OlTsymbal/Kyrsova-robota/3-амплітуда виходу(увх 1кгц 250мв).jpeg

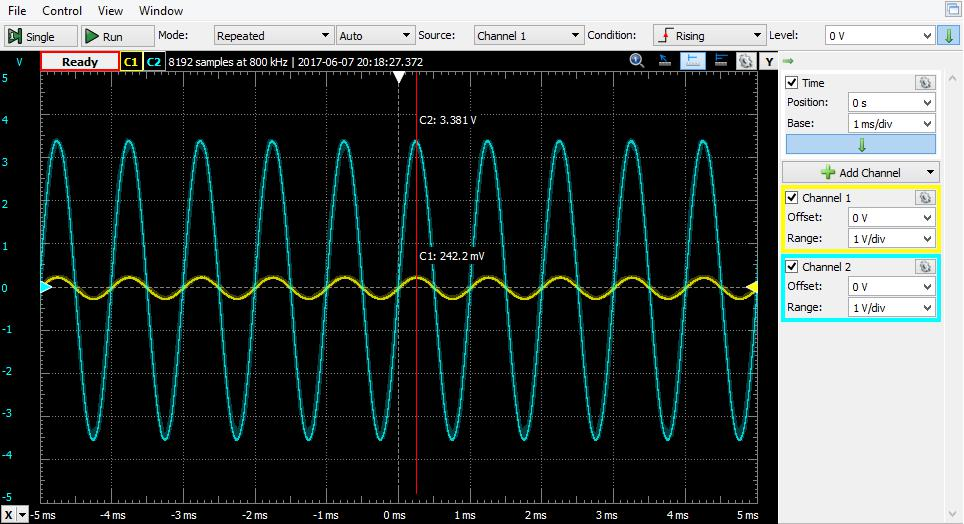
3-амплітуда виходу(увх 1кгц 250мв).jpeg
