OlTsymbal/Kyrsova-robota/3-амплітуда виходу1 - 50кгц.jpeg

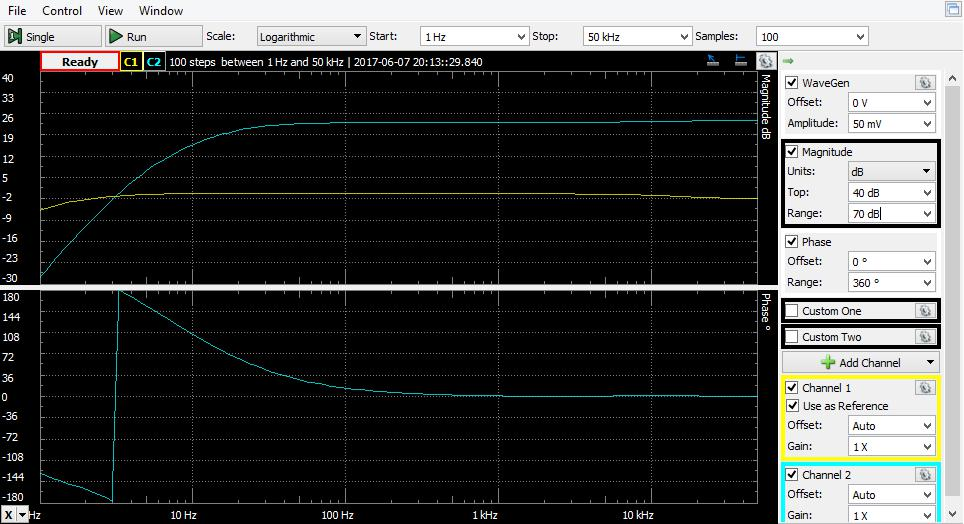
3-амплітуда виходу1 - 50кгц.jpeg
