OlTsymbal/Kyrsova-robota/3-амплітуда виходу2мгц.jpeg

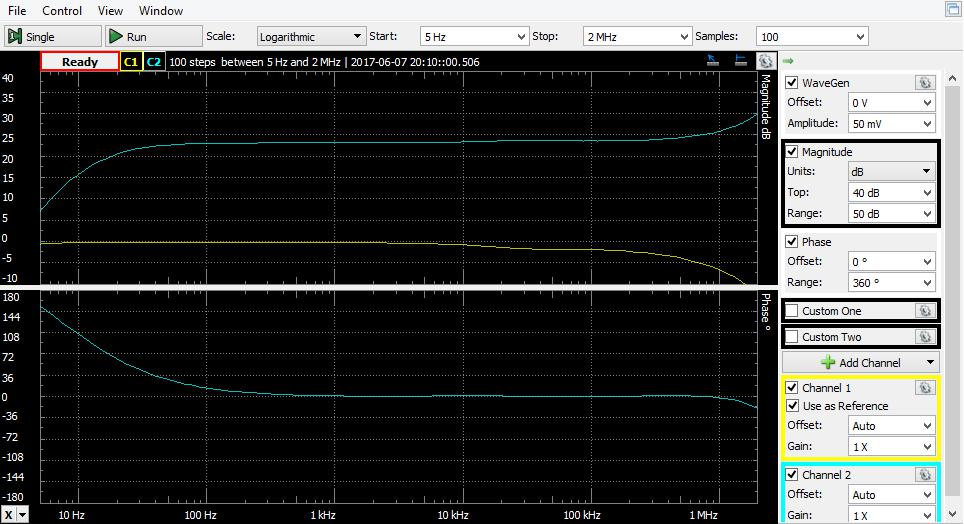
3-амплітуда виходу2мгц.jpeg
