OlTsymbal/Kyrsova-robota/3-амплітуда виходу(увх 0).jpeg

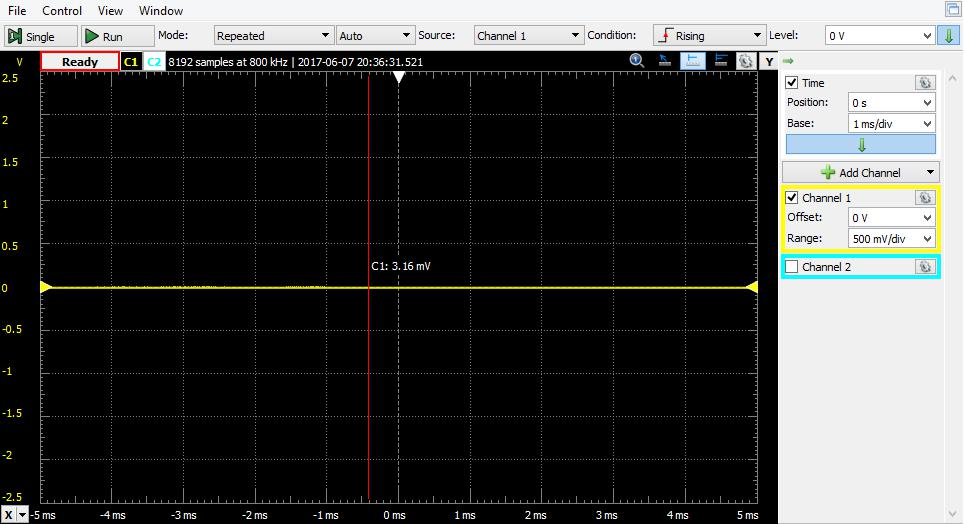
3-амплітуда виходу(увх 0).jpeg
