OlTsymbal/Kyrsova-robota/Виготовлення печатки.png

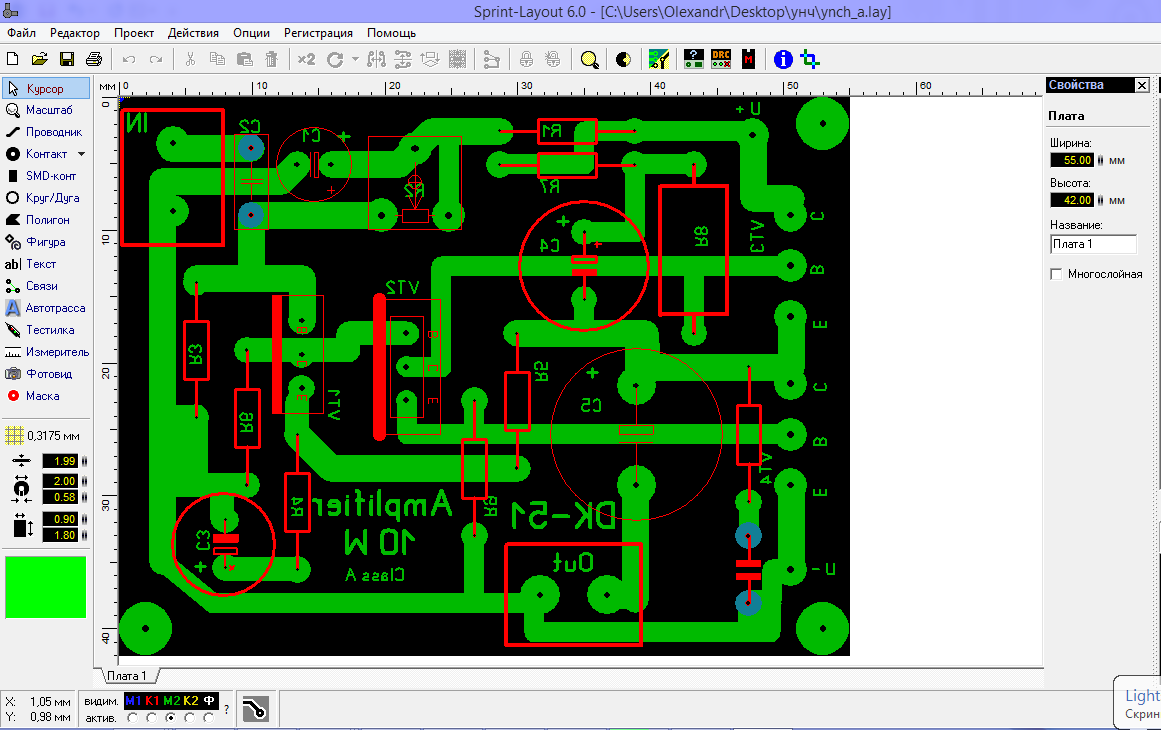
Виготовлення печатки.png
