OlTsymbal/Kyrsova-robota/Спрощена схема ВЕЛИКИЙ СИГНАЛ.png

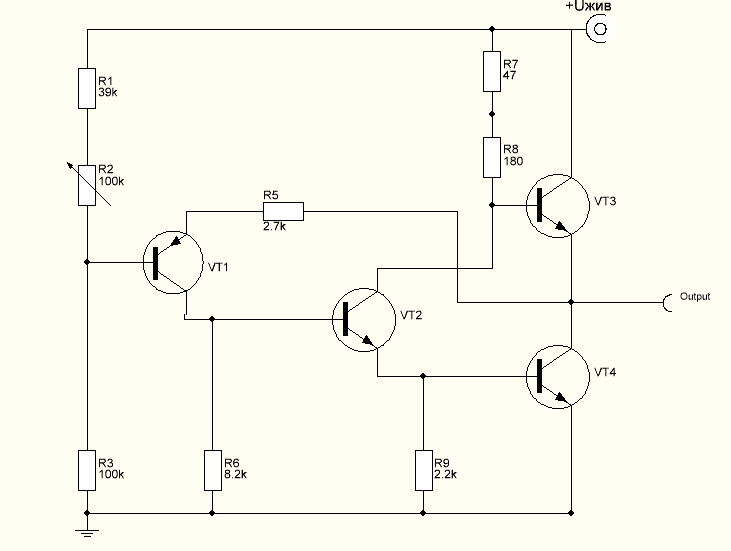
Спрощена схема ВЕЛИКИЙ СИГНАЛ.png
