OlTsymbal/Kyrsova-robota/ynch_a.lay].pdf

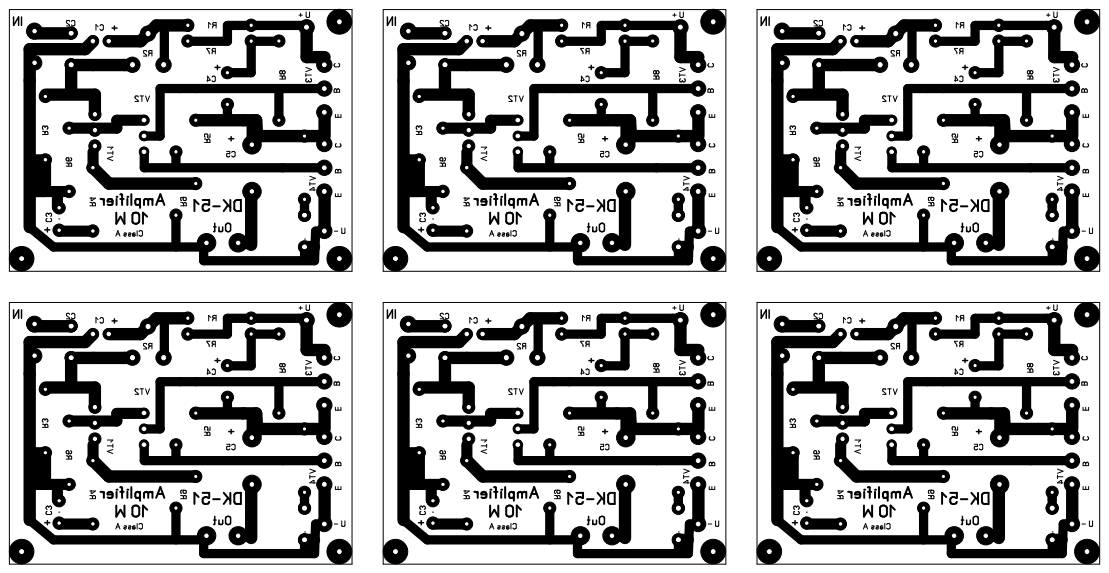
[picture p16: page 1]
