OlTsymbal/Kyrsova-robota/YN4.asc

C1: polcap; 100µ; V=25 Irms=250m Rser=0.6 Lser=0 mfg="Nichicon" pn="UPG1E101MPH" type="Al electrolytic"
C2: cap; 470n
C3: polcap; 220µ; V=25 Irms=600m Rser=0.13 Lser=0
C4: polcap; 470µ; V=25 Irms=750m Rser=0.16 Lser=0
C5: polcap; 2200µ; V=35 Irms=1.7 Rser=0.05 Lser=0
Q1: pnp; BC557B
Q2: npn; 2N3053
Q3: npn; 2SC5200
Q4: npn; 2SC5200
R1: res; 39k
R2: res; 100k
R3: res; 100k
R4: res; 220
R5: res; 2.7k
R6: res; 8.2k
R7: res; 47
R8: res; 180
R9: res; 2.2k
R10: res; 4
V1: voltage-; 12
V2: voltage-; SINE(0 0.1 50)
Named nets: 0
.tran 100m
