OlTsymbal/Kyrsova-robota/(list of files, drawings)

Other design files:
ynch_a.lay
